qgua2322/ELEC3607_carparkproject/README.md

# ELEC3607_carparkproject
2017 ELEC3607 project9 (USYD):  

## Team members: 
QISHEN GUAN 450549016  qgua2322@uni.sydney.edu.au  
MINGYUAN XIA  450549223

## Manul: 
file fsm : code on arduino   
file schematic: schematic of this project  
file android code: Our own control App  
file testcase : testcase of this project.  
3607report: ALL the detail of this project.  

## How to use:  
1. put fsm in ur Arduino due  
2. put unzip led.zip in file android code and then put it in Android studio then install this app on ur phone.
3. Connect all components as schematic
4. run the testcase to check whether all components are good.
5. Have fun

## Project description :  
The prototype will be in 2 parts, Arduino Due board with a Bluetooth shield in slave mode and an android phone as a controller. There are also several hardware components connected to Arduino in order to complete the full features we expected. 

An android phone acts as a controller (An App will be developed for user); it sends and receives data to/from Arduino board, once the phone connected with the board via Bluetooth(BT), the number of available car parking and further instructions will be displayed on the screen. Once the phone sends command to reserve: available car parking will be updated, and a confirmation message will be received as well. When user wants to leave, send “leave” and billing information will be received. After payment has been confirmed, free to go!

The Arduino Due board takes actions upon commands received via BT. A LCD screen is connected to the board to display number of available car parking, the screen is refreshed at a certain frequency to make sure it updates on time. Once the board receives a command of “reserve”, the board sends a message to corresponding servomotor to open the door. Infrared(IR) senor is detecting whether user’s car has come in or not. After user’s car come in, the board control servomotor to close the door and a time counter starts to work to record the time, which will be used to calculate parking fee. When the board receives “leave” command, billing information can be sent via BT and the payment will be made through a push button (not real payment, for demonstration purpose only). Once payment came through, door opens again and the car is free to go! After the door back to close, available car parking updates again.  

## Flowchart of arduino software:  
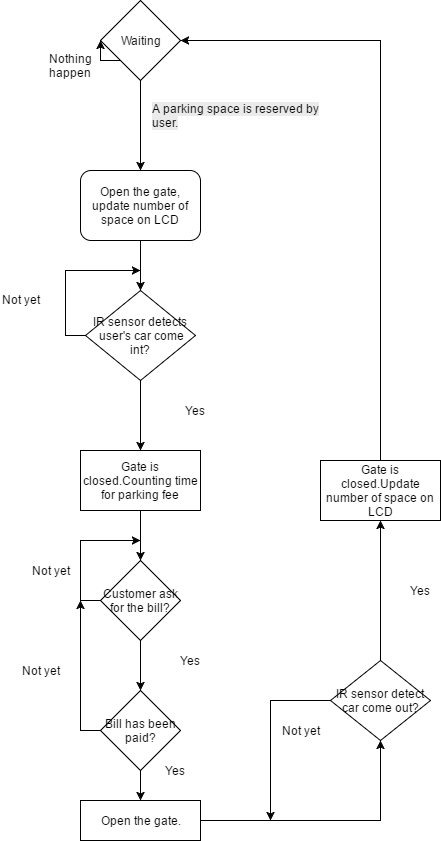
[picture p1: flowchart.png]
flowchart Flowchart


## Schematic: by KiCad
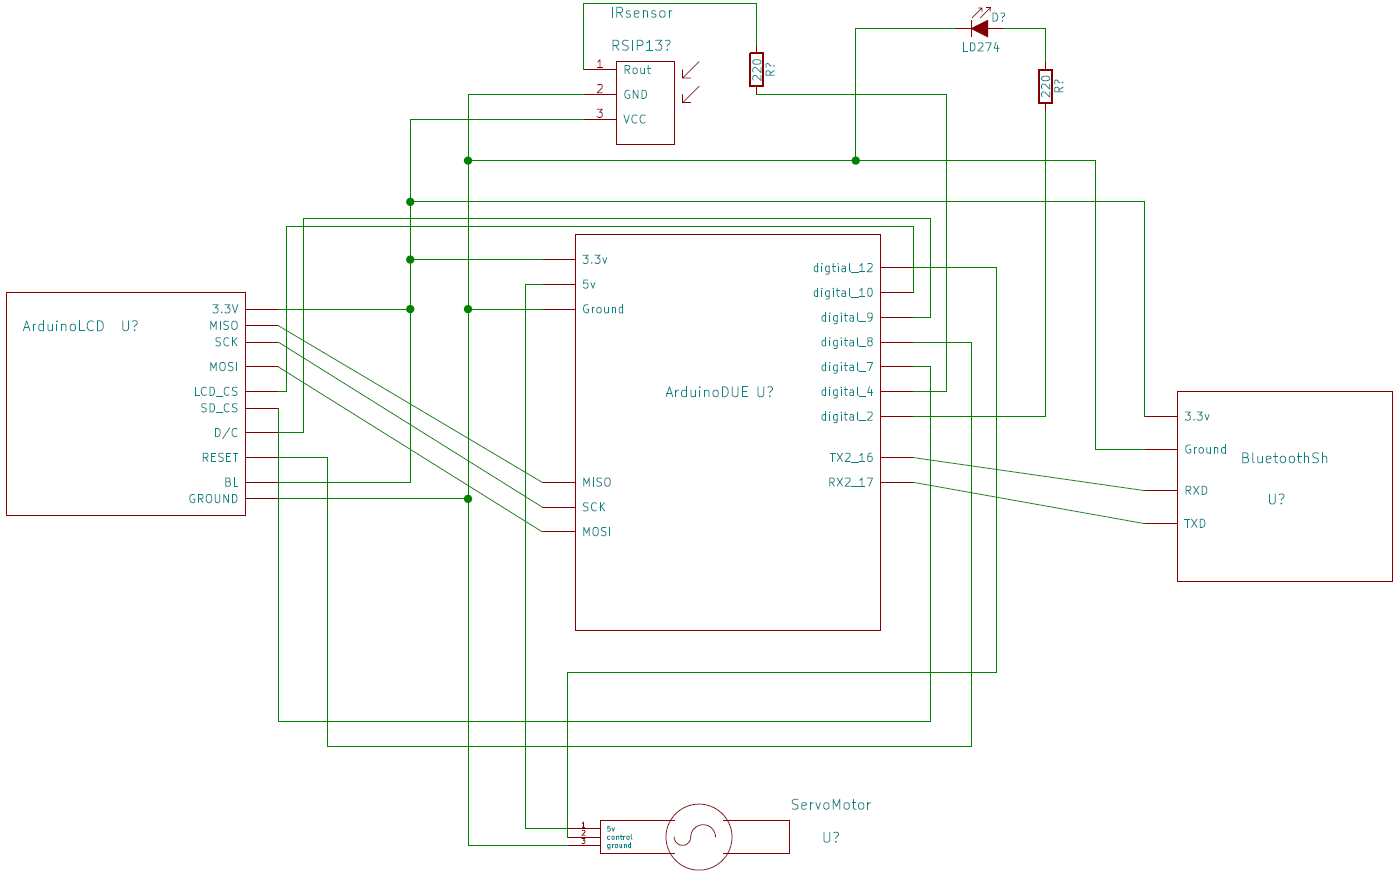
[picture p2: schematic.png]
schematic Schematic


## Reference:
Arduino pin map: https://www.arduino.cc/en/Main/ArduinoBoardDue  
Arduino due schematic:https://www.arduino.cc/en/uploads/Main/arduino-Due-schematic.pdf   
LCD connection:https://www.arduino.cc/en/Guide/TFTtoBoards   
LCD display:https://www.arduino.cc/en/Reference/TFTLibrary  
FSM in Appendeix A:https://flip.ee.usyd.edu.au/seiewiki/Labs/interrupts  
Bluetooth2.0: http://wiki.seeedstudio.com/wiki/Bluetooth_Shield  
Bluetooth4.0: http://linksprite.com/wiki/index.php5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  
Kicad tutorial: https://www.youtube.com/watch?v=o6IWdPpZ4mc  
Android tutorial:https://developer.android.com/training/index.html  
Android control APP: http://www.instructables.com/id/Android-Bluetooth-Control-LED-Part-2/
