qgua2322/ELEC3607_carparkproject/schematic/README.md

If  u just want to see schematic without changing anything, open ELEC3607SC.pdf  

If u want to change something, plz import Mylib.lib, then open ELEC3607SC.sch by KiCad
