qgua2322/ELEC3607_carparkproject/3607report.pdf

# ELEC3607 Project Group 9: A Wireless Car Park Reservation System Final Report Team members: Qishen Guan 450549016 Mingyuan Xia 450549223

# June/2017

# Project Implementation Summary Form

Category | List of items, with web link or page number where item is described
Open source compliance Are you publishing your code as open source? Explain what license you are using, or link to where you have published your project. | Yes, we publish it on github as open source, include all the code and schematic. We use MIT License, then everyone can use our code if they mention us. Link: https://github.com/qgua2322/ELEC3607_carparkproject
Platforms List the platforms you have used, including processor architecture (ARM, AVR, x86, etc.), programming languages (Python, C, C++, etc.), and IDEs. If you are not using Arduino Due, justify your choice of platform. | Arduino due(ARM): C++ Android phone(x86/ARM): Java
Sensors and inputs List your hardware inputs (push buttons, analog sensors, I2C or SPI sensors including accelerometers, etc.) and mention on which page each input is described. | IR sensor(page5)
Outputs List any mechanical, visual or other type of outputs controlled by your hardware (motors, magnets, LED, 7-Segs, LCD, etc.) and mention on which page each input is described. | IR LED, Servo motor, LCD (page 5-7)

Connectivity List any protocols used for communicating between your main controller and any other microcontroller excluding sensors or actuators (USART, UART over USB, Bluetooth 2, Bluetooth 4, Wi-Fi, ZigBee, etc.) and mention on which page each input is described. | Bluetooch 4.0 and Bluetooth2.0(page5-7)
Graphical User Interface List any GUI used for interfacing users (local LCD, Phone app, Desktop app, Web app, Web dashboard, etc.) and mention on which page each input is described. | LCD and custom App on Android (page5-7 for LCD, Page 8 for custom App on Android)
Algorithms / Logic List substantial control algorithms (state-machines, real-time operating system, filesystems, feedback algorithms, mathematical transformations, etc.) and mention on which page each input is described. | FSM (page6-7)
Physical case and other mechanical consideration List what casing or mechanical systems have been used in your project (3d prints, pipes, cardboard mechanics, etc.) and mention on which page each input is described. | NO

### 1. Abstract

The following project we designed and built is a wireless car parking/billing system. An android device is allowed to communicate with the prototype via Bluetooth 4.0 by using our customized android app. At the car parking lot, a LCD screen will display the number of available car parking, this information is sent to paired android phone as well. On the other hand, the phone app plays the role of a remote controller, it has “reserve”, “leave”, “pay”, “disconnect” buttons and fulfill these functions correspondingly. This will be discussed in detail in Design section. After we built the prototype, we ran tests to test whether it achieved our goal. We found that it was hard to synchronize Arduino Due and the phone, so we always lose a word or two upon receiving messages. This will be expanded in Trouble-shooting section. After the tests, although we approached our expectations, there is much more thing can be done to improve, such as using WIFI instead of BT; but due to time limitation, we left our prototype as what it was. This project is extremely helpful in regarding to gain a better understanding of communications between embedded system & others, and simple real world embedded system design.

### 2. Aim and difficult:

Live in city like Sydney, a daily headache is to find a parking spot at your travel destination. The time of finding a spot occupies a great percentage of your commuting time, if you live in city, the percentage is even higher. Therefore we came up with an idea of a wireless parking/billing system that can check availability and reserve a parking spot before your arrival. Furthermore, you can also view your bill on the phone in real time and pay your bill when you are leaving.

3.Design:
3.1: Components list:
Equipment : | amount
Arduino due | 1
Bluetooth 2.0 shield | 1
Bluetooth 4.0 shield | 1
Servo motor | 1
IR LED | 1
IR sensor | 1
LCD display | 1
Resistor 220 (ohm) | 2

3.2: Use of each components:
Arduino Due board is the core of this embedded system. All the other components are connected on it. It process the message that is sent from user’s App, then output the response to LCD and user’s App at the same time. And control the parking space’s gate open or off by reading IR signal.

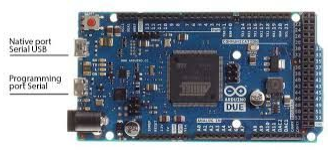
[picture p5: figure]

Bluetooth 2.0/4.0 shield provide a wireless connection between embedded system and user’s phone App. (Our project used BT2.0 at first, then switch to 4.0 later, Check 3.7 How does this project work to see how to use different version of BT)

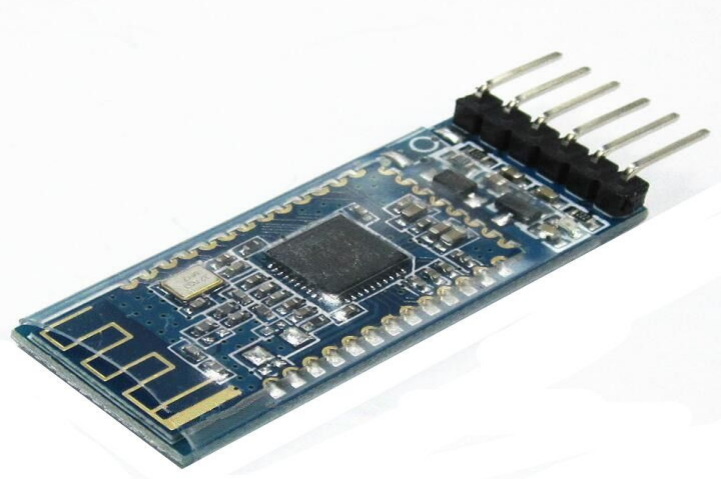
[picture p6: figure]

Servo motor is used to open/close the gate of our parking space

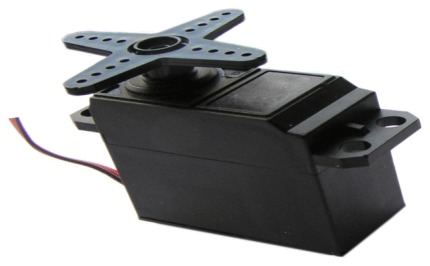
[picture p7: figure]

IR LED and IR sensor is used to detect whether customer’s car has parked in or not, in order to close the gate automatically when car has parked in or close the door when customer has left. The reason that choose infrared as detection light is: infrared light is not common in environment light, so it will not be impact very easy by environment. And it is invisible for human.

LCD screen always display the number of free space is remaining, and display the information at each stage. For example: display how long does user’s car have been parked in/ How much does user have to pay.

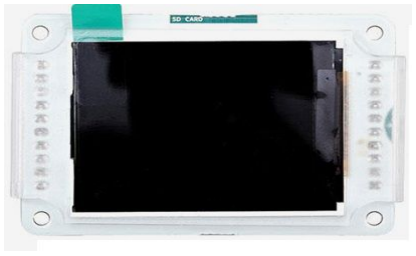
[picture p8: figure]

### 3.3 Hardware schematic: Appendix 1

### 3.4 Software flowchart: Appendix 2

### 3.5 Arduino code: Appendix 3

### 3.6 Android App’s code: Appendix 4

### 3.7 How does this project work:

This system uses a Finite state machine(FSM) as the control mechanism, because in FSM we don't need to worry about customer mispress some wrong button(Except "Disconnect"),then the system get into an unknown situation. For example, nothing will happen when customer press "pay" before "leave".Things only be processed in a sequence that we want.

Bluetooth is used as wireless connection, but Arduino Due board does not support SoftwareSerial library, so we need to implement hardware serial to Bluetooth, in order to get it work. (Bluetooth’s TX connect with Arduino’s Serial2’s RX, bluetooth’s RX connect with Arduino’s Serial2’s TX, this is same for both BT2.0 and 4.0. If choose Bluetooth 4.0, uncommand setupBlueToothConnection4() in function void setup() in fsm.ino , command setupBlueToothConnection(), and vice versa.
)

This embedded system implement two Timer counters(TC) to achieve time counting and generate a squarewave. We turn TC0 on to generate a 36K Hz square wave signal on digital pin 2, because Arduino Due does not support Tone library. We generate such high frequency signal because it isn't common in environment light, so it is not easy to be affected by surrounding circumstance. TC1 is used to count how long does user’s car stay.

Expected operating procedure: When user press “reverse” button on the phone, our embedded system will control the servo motor to open the gate, and update number of free space on LCD. The system will not count time immediately, it will wait until IR sensor detect user’s car has parked in, and the gate is fully closed. After that embedded system will update the time to LCD and user’s phone simultaneously. When user decide to leave, all he needs to do is to press “leave”, then the bill will come up on LCD as well as user’s phone. Once user press

“pay”, the user is good to go. System will control motor to open the gate, and it will only close after IR sensor detects IR light(meaning the car has left).

3.8 Design verification and result.

IR LED and Sensor: IR light is invisible to human eye, so we used an android phone’s camera with a IR filter to check whether it is operating, And we see a purple light show on IR LED when it is operating. To test IR sensor, we put IR LED face with IR sensor, when there is nothing a ‘0’ show on monitor. After that we put a book in between, a ‘1’ show on monitor, when we remove it ‘0’ come back.

Servo motor: myservo.write(30); move forward, myservo.write(120); move backward myservo.write(90) stop. Work as expected. LCD: We print a “hello world” on LCD by TFTscreen.text("Freespace:.", 0, 40); then change the second or third argument of this function to change the position on the LCD screen. Change first argument to output different string. It all work as we expected.

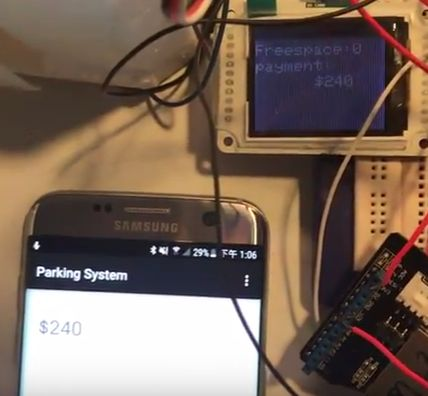
[picture p9: figure]

Bluetooth 4.0 and App: Using off the shelf App: Bluetooth Terminal to send and receive some Strings from embedded system. No characters lost in sending or receiving String. Using our customised app, no charate lost in Sending message to embedded system, some character lost in receiving String from embedded system. We decide to add space buffer to the String being sent from embedded system. No chartered lost anymore.

FSM: we test our FSM by pressing the button on the App in unexpected sequence. Like press “pay” before “leave”. No matter what we did, the system only operated in a sequence that we expected. (Unless someone reset the board,or disconnect the power, then that App may break or receive a error message.)
All parts are being verified as what we expected.

App design:
The android app is designed base on an android Bluetooth app tutorial using android developer tool called Android studio, this tutorial is in the reference named Android control app.(Ref 10) The tutorial provides a detailed procedure of creating an app that uses Bluetooth as communication tool. We used the tutorial as a learning material, and create our app follow the tutorial structure. Then we modified our code based on it to suit our needs.

We added more buttons to the user interface and complete their functions correspondingly. We add a textview widget to continuously refresh information displayed on the phone, this is done by using MyAsyncTask(). What it does is to create another thread that will constantly read input string from Bluetooth socket in background. A Timer() is introduced to delay the initialization of MyAsyncTask in order to keep the welcome screen for few seconds. The Timer also controls the time between every execution of MyAsyncTask;therefore the information displayed is refreshed at certain frequency without being interrupted by other button operations. The app happened to crash several times during testing, we managed to sort this out somehow, but as this project is not focused on android we didn’t go deep into it and stopped at where we thought it was enough.

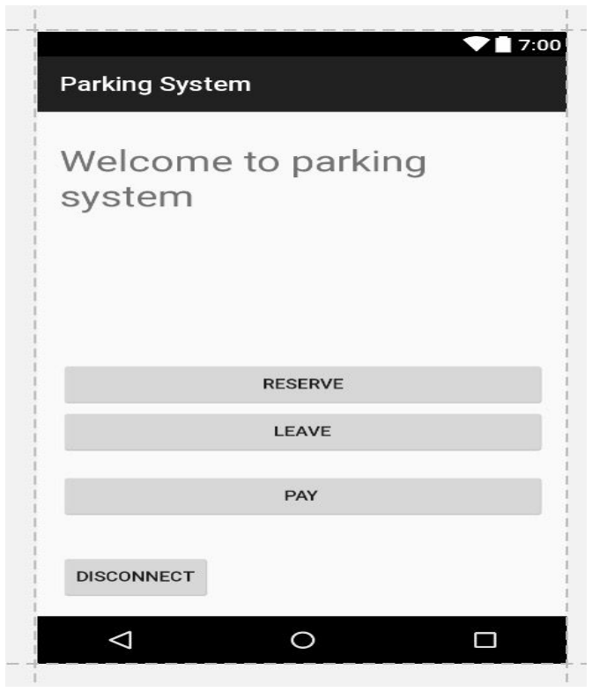
[picture p10: figure]

4.Trouble-shooting:
There were both hardware and software problems occurred during this project:
1. In order to communicate with phone via Bluetooth, we add a Bluetooth shield to Arduino Due board. Normally, when adding a Bluetooth shield to Arduino, we plug the whole shield on top of Arduino board to let pins on the Bluetooth shield inherits the pins on Arduino. But for this particular Arduino Due board, if we had done the connection this way, many digital pins on the Due board will be blocked by the shield; and we do need those pins to fulfill our other functions, for instance the pins to connect LCD’s
MISO,MOSI and SCK were blocked by the shield. Therefore we decided to power up the shield via wires and connect output/input pins as well. Although this connection takes more space, it provides a large range of accessible pins to suit our needs.
2. A proper installation of LCD screen onto breadboard could not be done due to the width of LCD screen. The LCD screen happened to be a bit wider than the width of pin matrix on breadboard; therefore we could not plug in both pin vectors on breadboard. Fortunately, after researching, we found that only connect the pin vector on left is enough to drive the LCD screen. So we plugged in the left half and let the right half hang at edge of the breadboard.
3. In regarding to the detection of whether the car is in parking lot, we used a pair of IR LED and IR sensor. Upon testing if this pair is working, we found that our sensor could not detect the IR light from IR LED. This meant either our LED was not working or our sensor was broken. To test the IR LED, we used a phone camera that turns IR filter off and we saw nothing is emitting from the LED.So we went back to double check our code which drives LED and as well as our circuit connection. We used oscilloscope to measure voltage across LED, the result showed it was in right frequency but Vpp was too low. Due to this, we reduced the resistance of series resistor (voltage divider) to 230 ohms to allow more voltage drop across the LED. After this we used camera again and observed a purple-ish light was emitted from LED but only at a certain angle. We corrected the LED position to ensure the IR light will propagate to IR sensor and successfully detected the IR light.
4. The synchronization issue was the main software problem encountered in this project. In our design, the Arduino Due will send messages to the phone via Bluetooth, and the app will pick up the messages then display on the phone screen. But as they were not synchronized, every time the massage was refreshed on screen, it might lose some part of the original message. For example, Arduino sends “freespace: 1” but only an “eespace: 1” message will appear on the phone. In order to solve this, rather than dig deep to understand both devices’ operating rates, we decided to solve this in a much simpler and less time consuming way: adding buffer. Instead of sending “freespace: 1”, we modified our code to send with buffer “ freespace: 1 ”. On the other hand, the code of app was modified to display everything that is not a “space”. For instance, if the Arduino sent “ freespace: 1 ” and the phone received “ freespace: 1 ”, the buffer at front did it work and maintain the main message. After automatically deleting spaces, a message of “freespace: 1” will be displayed on screen. Although this solution is not perfect, it satisfies our need at this stage.

### 5. Improvements

Our project has a great potential in terms of improvements：
The first that comes to our mind is to use WIFI instead of Bluetooth for communication; this will improves the communication range by a large factor to make this project more practical and utilized.

Secondly, as mentioned in trouble-shooting, dig into the synchronization issue and solve it from a deeper level. This will make our app react faster and improve the stability under load.

Additional improvement for app would be a better looking user interface which is user friendly. In terms of the prototype, we could add more components to achieve more functionality. For example, we could add red and green LED to indicate if there is any available parking spot; use LCD to display more information and even images; create more parking spots; add temperature sensor to detect fire emergency and a speaker to warn people if emergency occurs.

6.Cost:

Component: | Price | quantity | Total
Arduino due | 50 | 1 | 50
Bluetooth 2.0 shield | 20 | 1 | 20
Bluetooth 4.0 shield | 59 | 1 | 59
Servo motor | 16 | 1 | 16
IR LED | 1 | 1 | 1
IR sensor | 2.5 | 1 | 2.5
LCD display | 22 | 1 | 22
Resistor 220 (ohm) | 0.1 | 2 | 0.2
Total | | | 170.7(AUD)

### 7. Conclusion

In conclusion, we successfully implement a wireless car parking/billing system using Arduino Due and an android phone. Our prototype completes most of our expectations and at some point it even exceeds our plan. (“Pay button” in app replaces the hardware button in the original plan) We worked hard and put efforts into this project as it continuously give us positive feedbacks and joy. This experience is valuable to us because it is like a bridge links the theorem to reality. By designing and completing this project, we have gain experience on how to apply our knowledge to a real world problem/application. Although this project is rather simple than anything that is worthy to talk about, it is a great start for understanding embedded systems. Additionally, this project reinforced our team-work skills such as communication skills as it requires a team work.

Open Source to GITHUB：https://github.com/qgua2322/ELEC3607_carparkproject

Reference :
1.Arduino pin map: https://www.arduino.cc/en/Main/ArduinoBoardDue
2.Arduino due schematic:https://www.arduino.cc/en/uploads/Main/arduino-Due-schematic.pdf 3.LCD connection:https://www.arduino.cc/en/Guide/TFTtoBoards
4.LCD display:https://www.arduino.cc/en/Reference/TFTLibrary
5.FSM : https://flip.ee.usyd.edu.au/seiewiki/Labs/interrupts
6.Bluetooth2.0: http://wiki.seeedstudio.com/wiki/Bluetooth_Shield
7.Bluetooth4.0:
http://linksprite.com/wiki/index.php5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 (http://linksprite.com/wiki/index.php5)
8.Kicad tutorial: https://www.youtube.com/watch?v=o6IWdPpZ4mc
9.Android tutorial:https://developer.android.com/training/index.html
10.Android control APP: http://www.instructables.com/id/Android-Bluetooth-Control-LED-Part-2/

Appendix 1 : Schematic by Kicad (Please go to github for a better version)

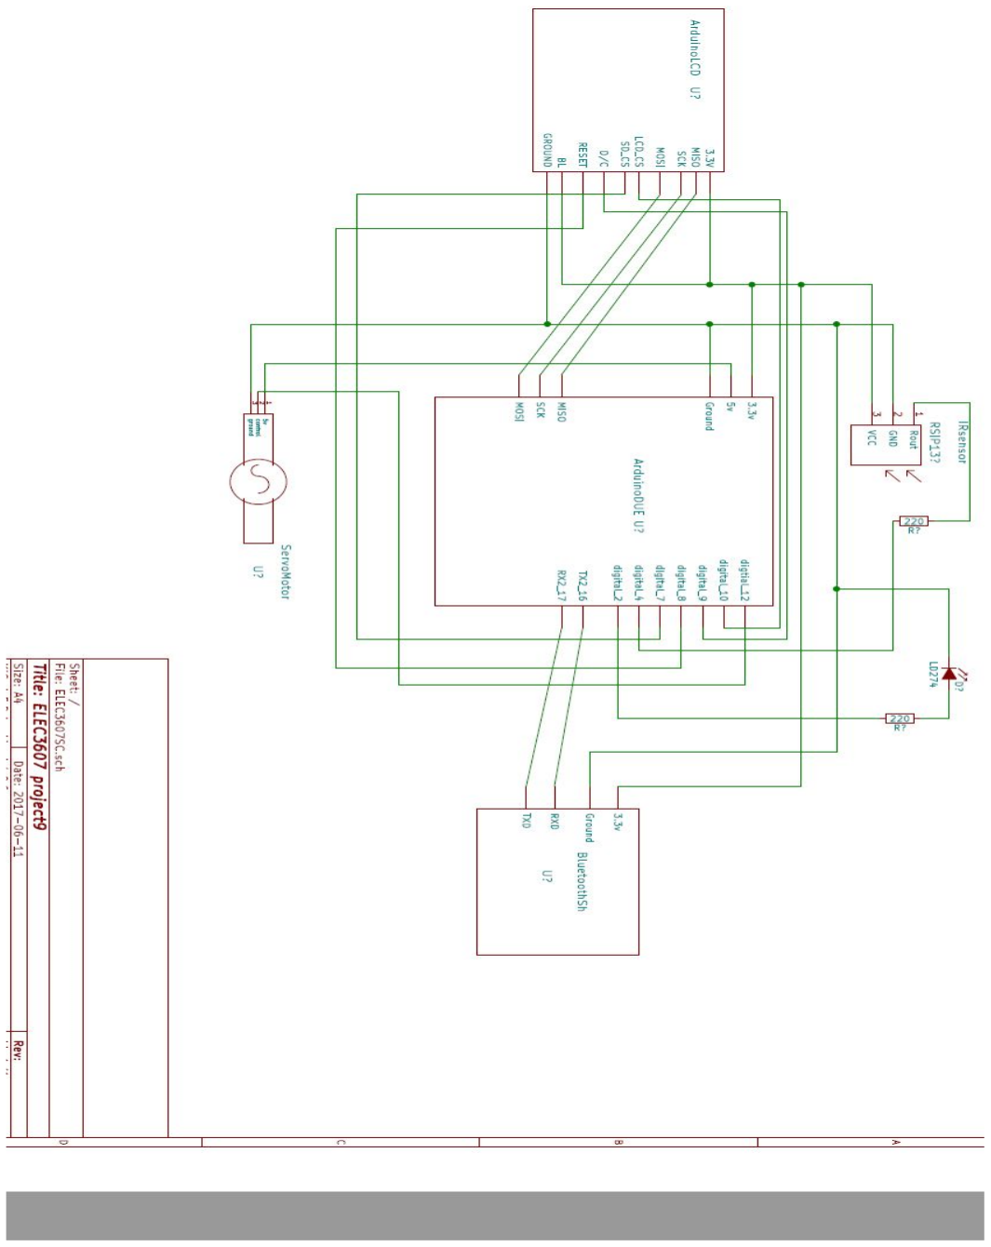
[picture p11: figure]

Appendix 2: software flow chart

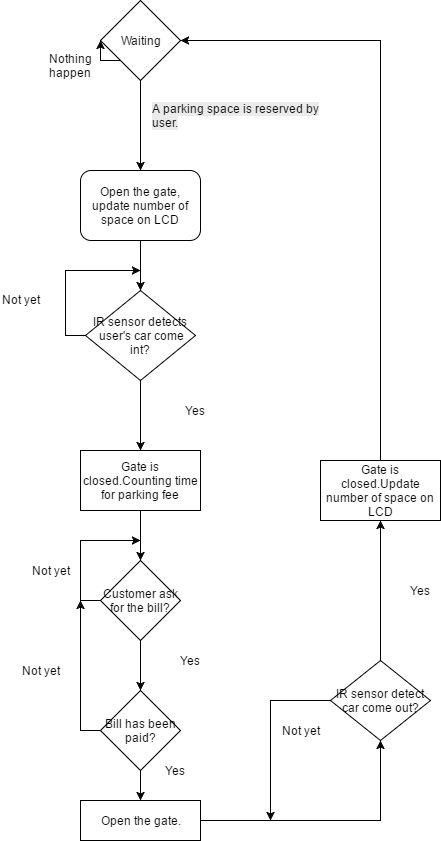
[picture p12: figure]
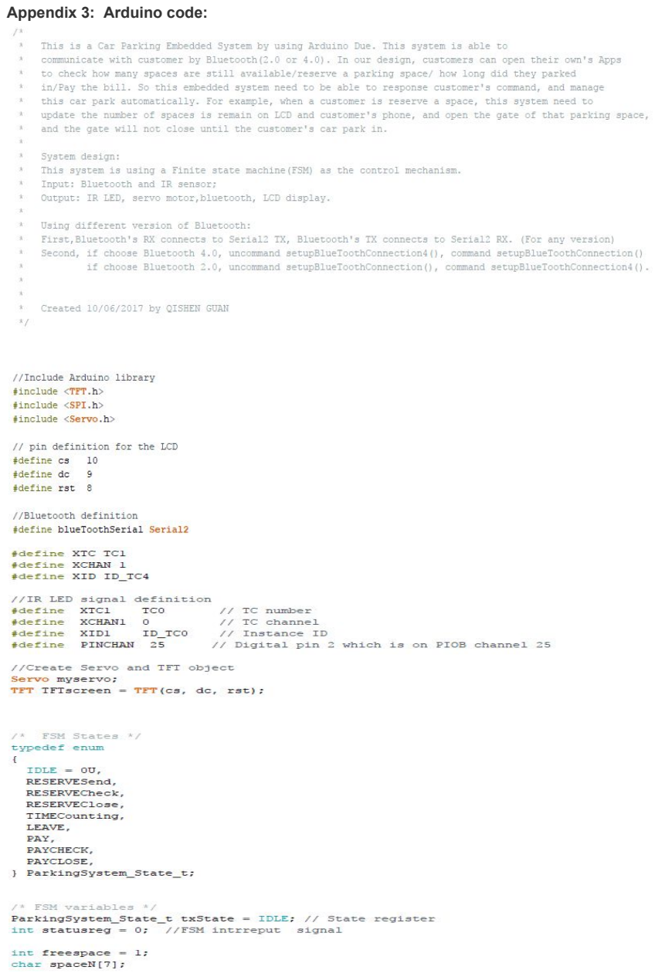
[picture p13: page 14]

Appendix 3: Arduino code:

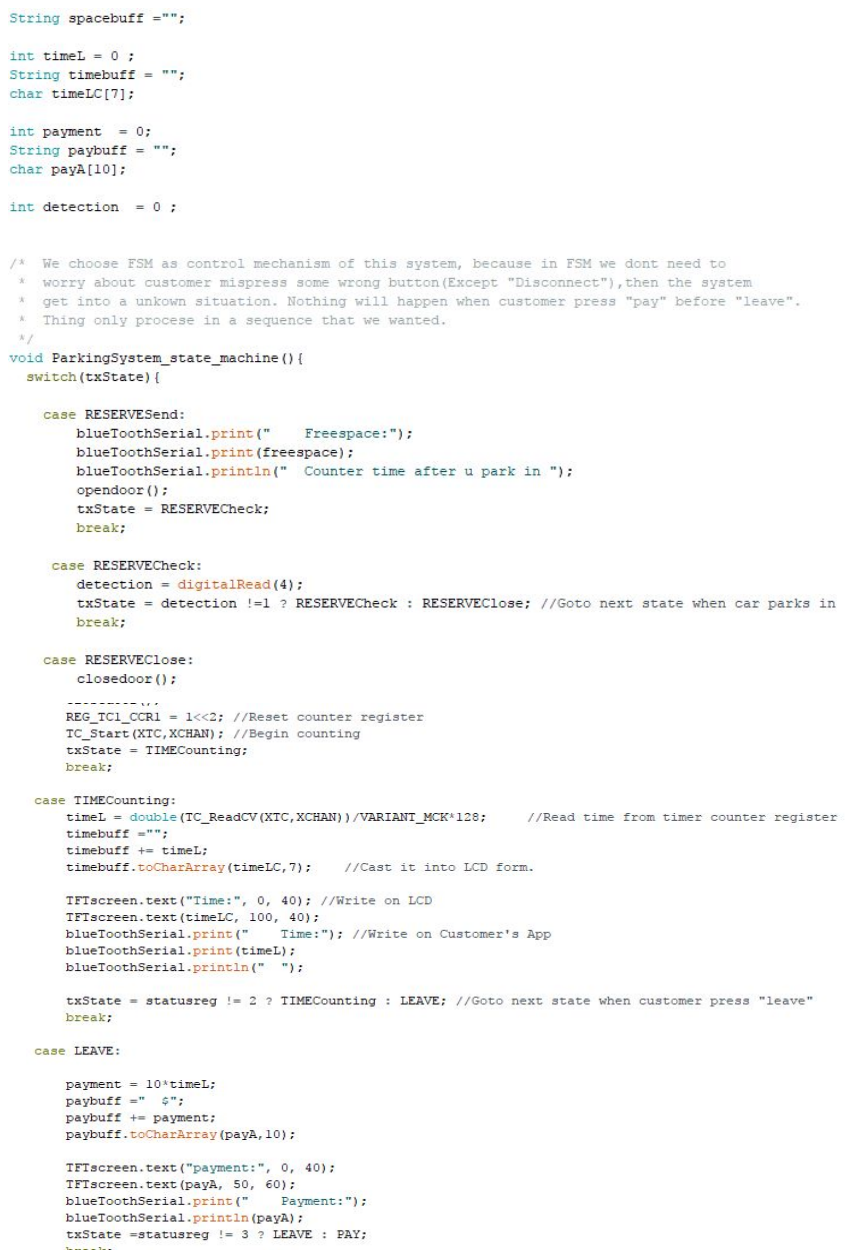
[picture p14: page 15]

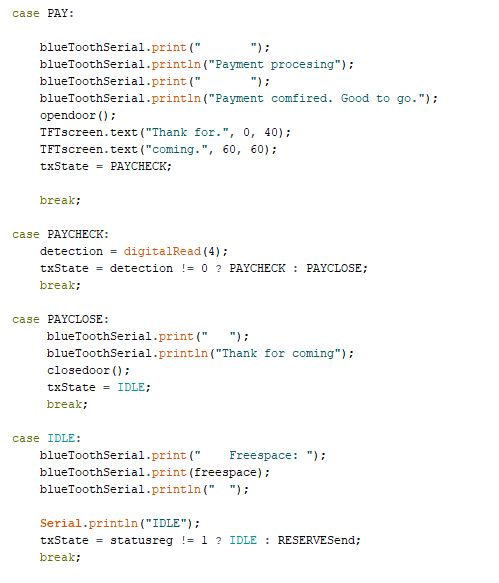
[picture p15: figure]

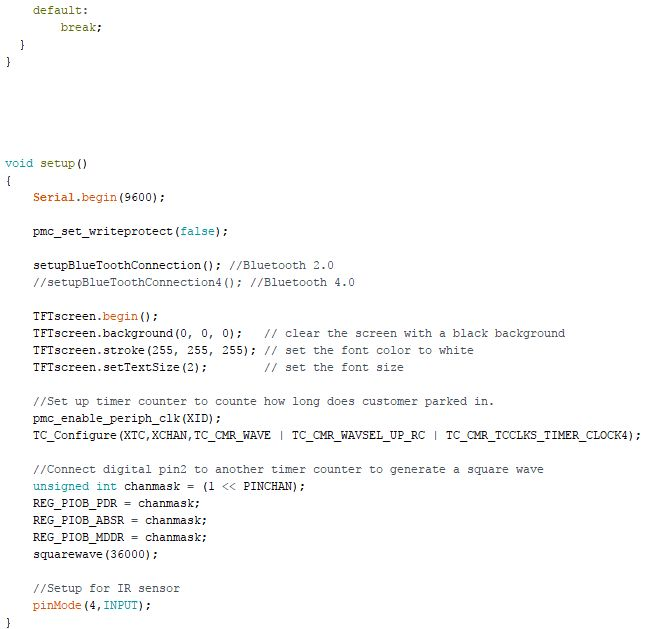
[picture p16: figure]

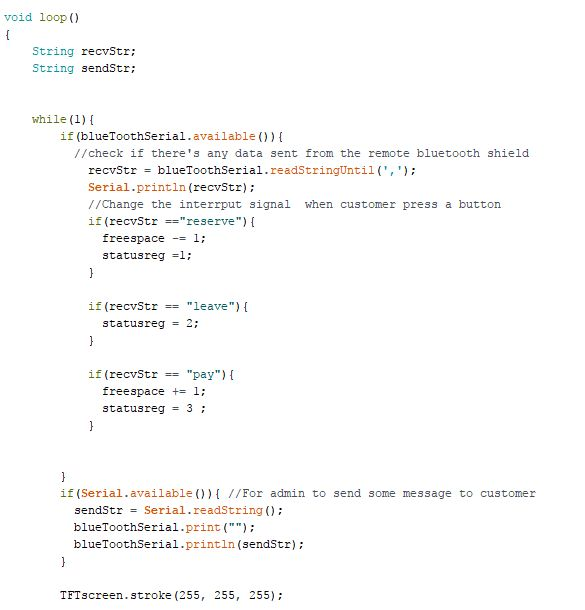
[picture p17: figure]
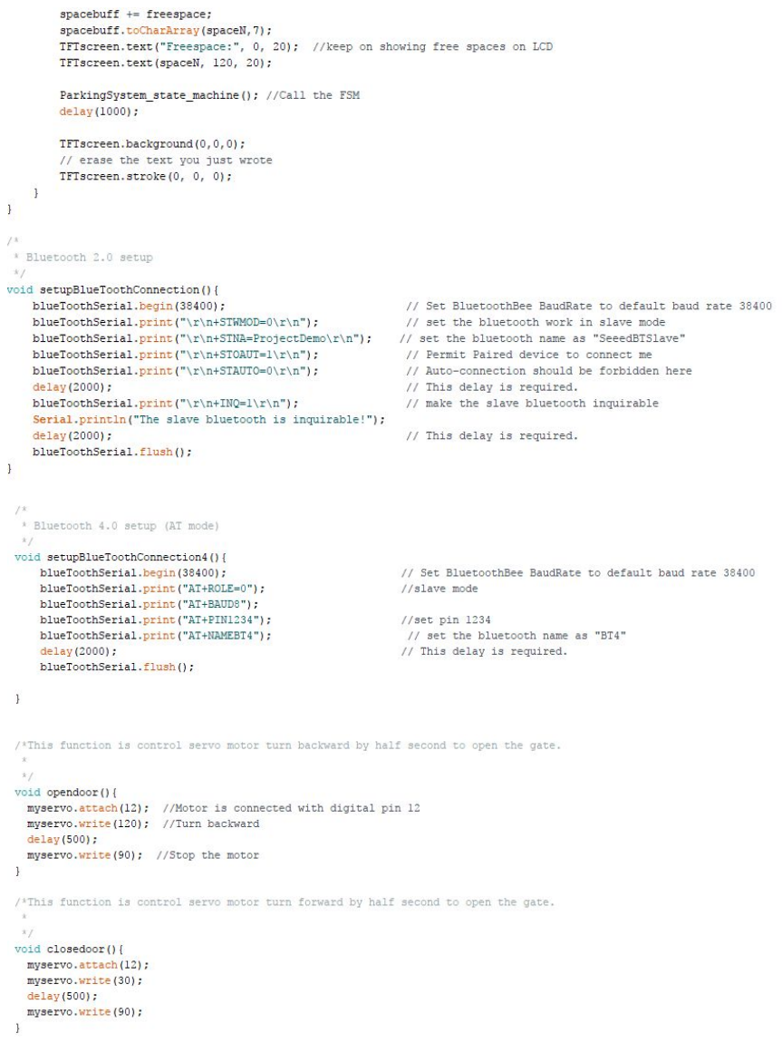
[picture p18: page 19]

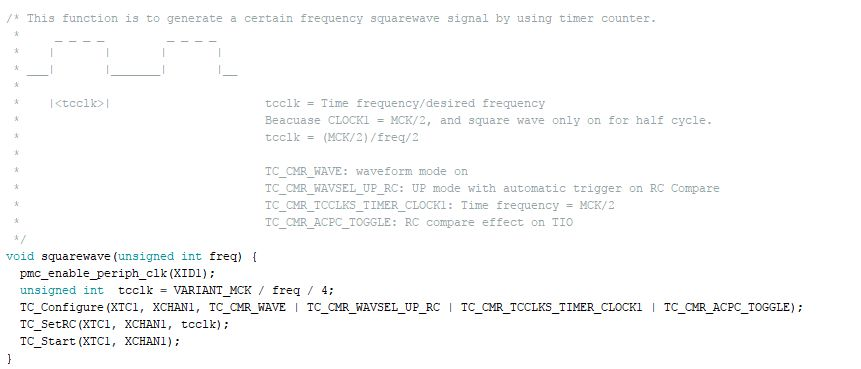
[picture p19: figure]

Appendix 4: Android code: Control.java

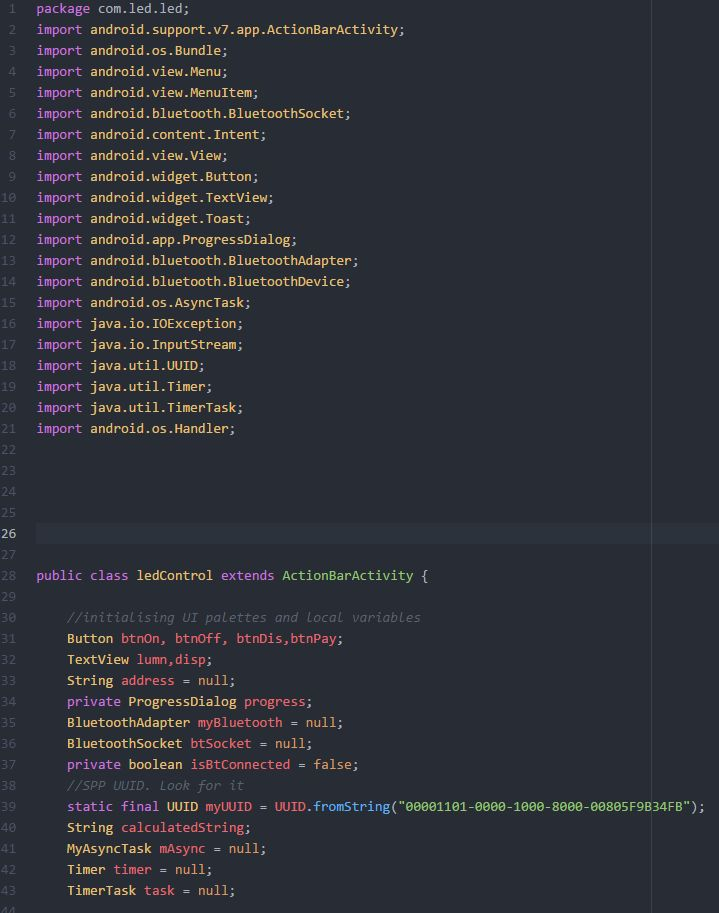
[picture p20: figure]

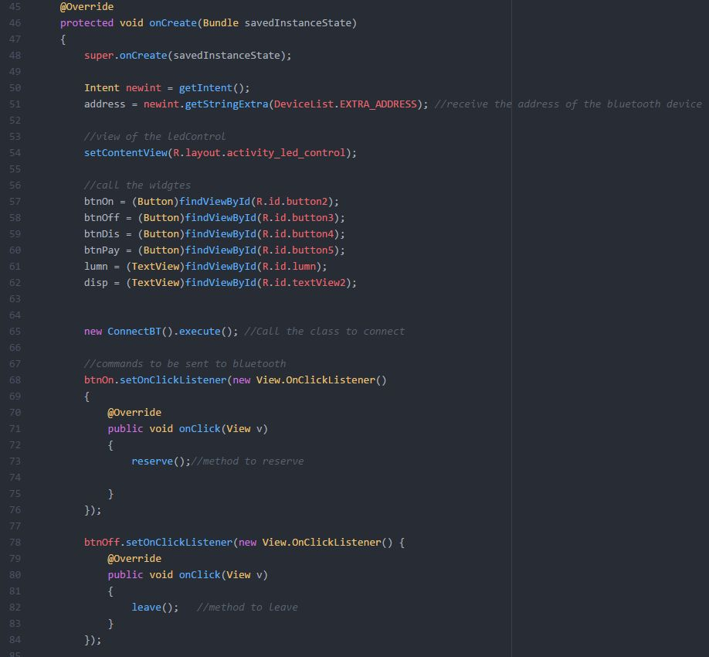
[picture p21: figure]

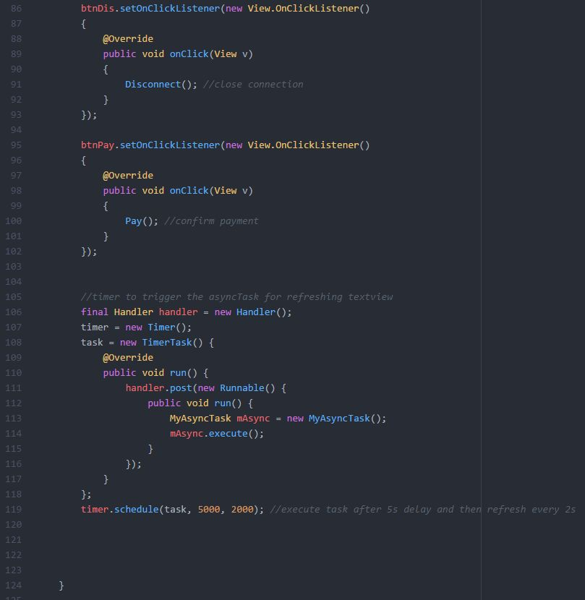
[picture p22: figure]

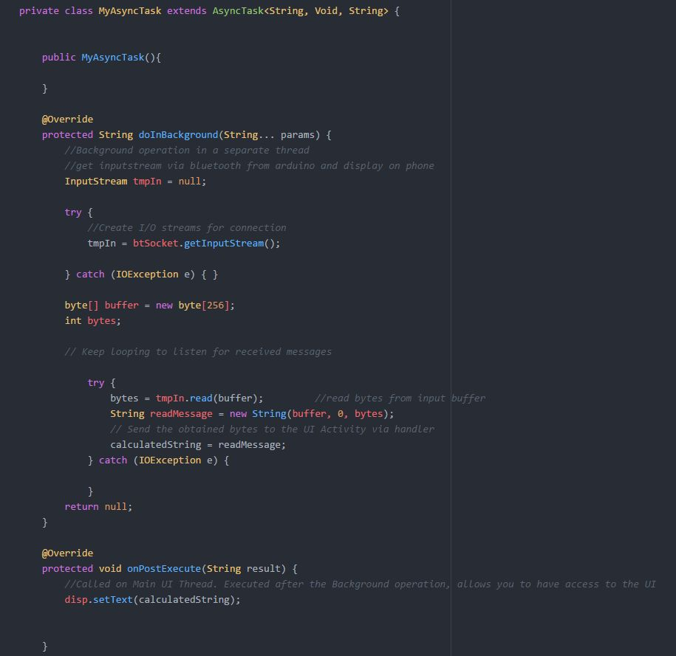
[picture p23: figure]

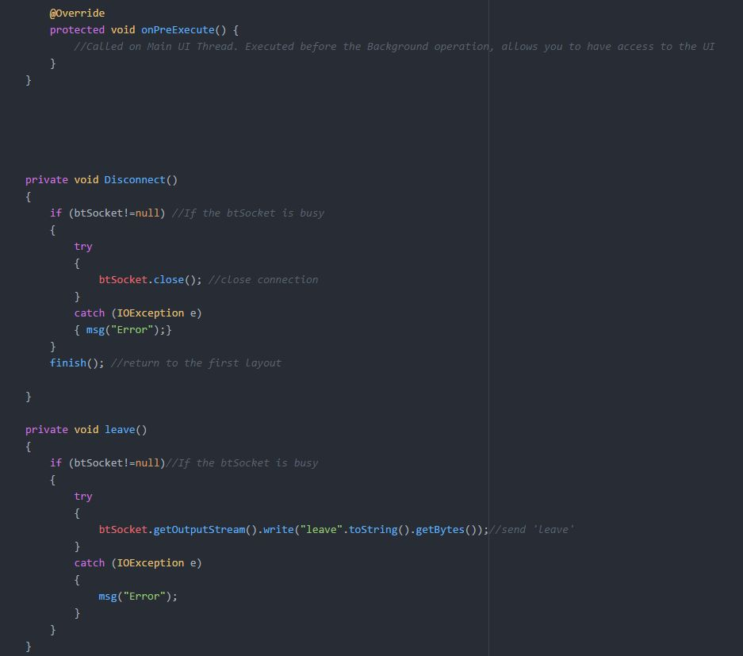
[picture p24: figure]
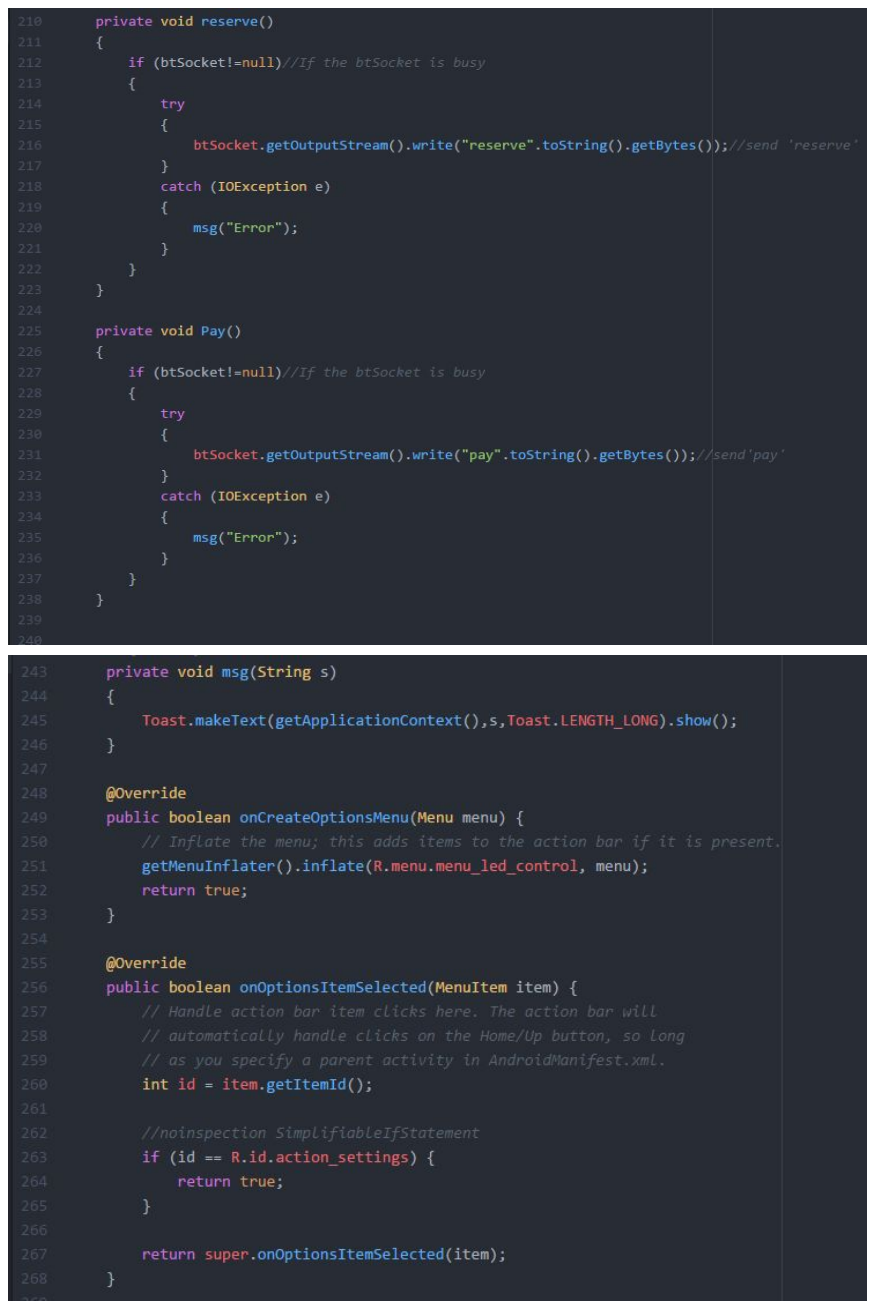
[picture p25: page 26]
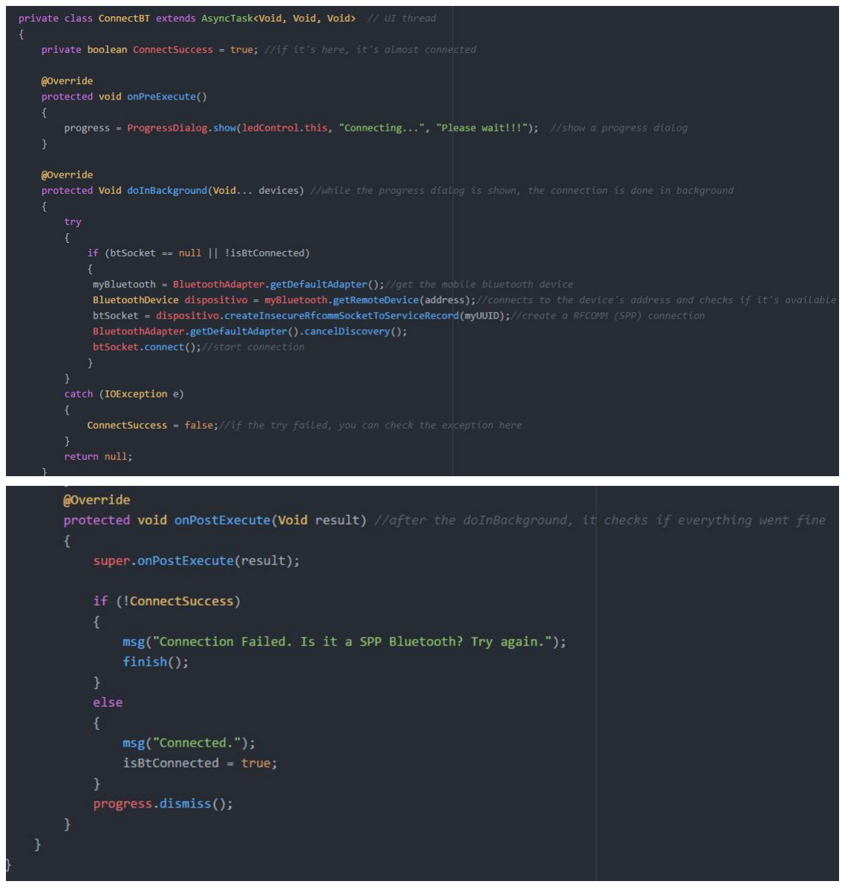
[picture p26: page 27]

Android code: DeviceList.java

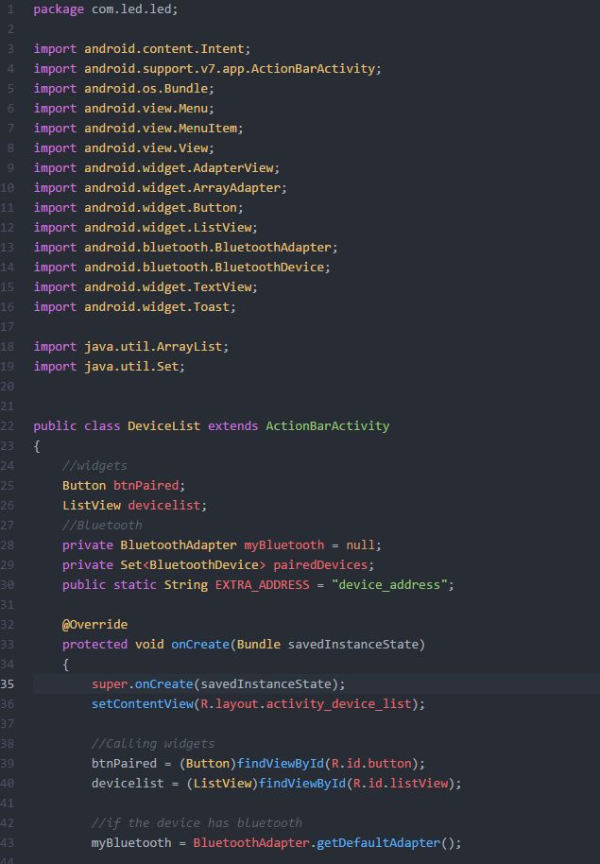
[picture p27: figure]
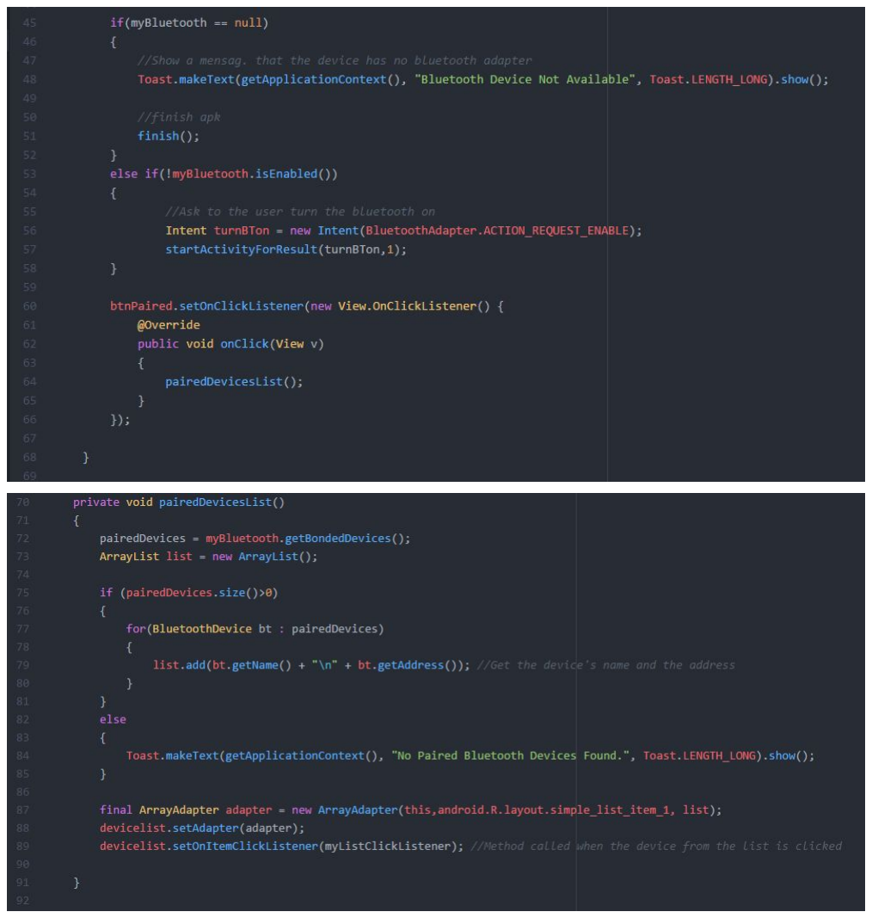
[picture p28: page 29]

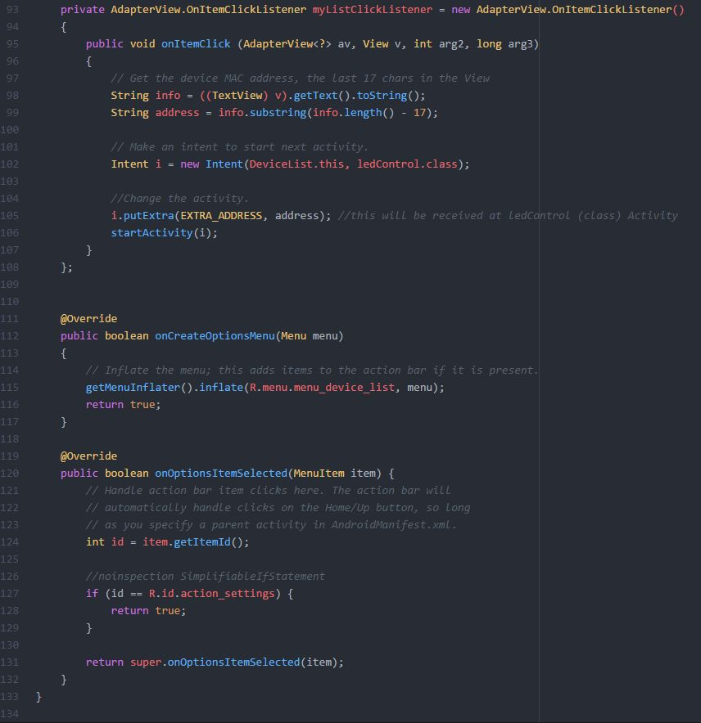
[picture p29: figure]
