qgua2322/ELEC3607_carparkproject/testcase/testcase.txt

Test cases:
1.	Pair device ¨C reserve ¨C door opens ¨C park in ¨C door closes ¨C wait few seconds ¨C leave ¨C pay ¨C door opens ¨C car left ¨C door closes ¨C back to first state.
2.	Pair device ¨C reserve ¨C door opens ¨C park in ¨C door closes ¨C wait few seconds ¨C leave ¨C  do not pay ¨C door keeps closed until pay ¨C door opens - car left ¨C door closes ¨C back to first state.
3.	Pair device ¨C reserve ¨C door opens ¨C do not park in ¨C door keeps open ¨C park in - door closes ¨C wait few seconds ¨C leave ¨C pay ¨C door opens ¨C car left ¨C door closes ¨C back to first state.
4.	Pair device ¨C reserve ¨C door opens ¨C park in ¨C door closes ¨C wait few seconds ¨C pay ¨C nothing happens - leave ¨C pay ¨C door opens ¨C car left ¨C door closes ¨C back to first state.
5.	Pair device ¨C leave ¨C nothing happens ¨C pay ¨C nothing happens ¨C disconnect ¨C app quits
