qgua2322/ELEC3607_carparkproject/testcase/ReadMe.md

testcase.txt is the testcase for this whole project.  

If u want to test individ component, plz open functiontest.
