qgua2322/ELEC3607_carparkproject/schematic/ELEC3607SC.pdf

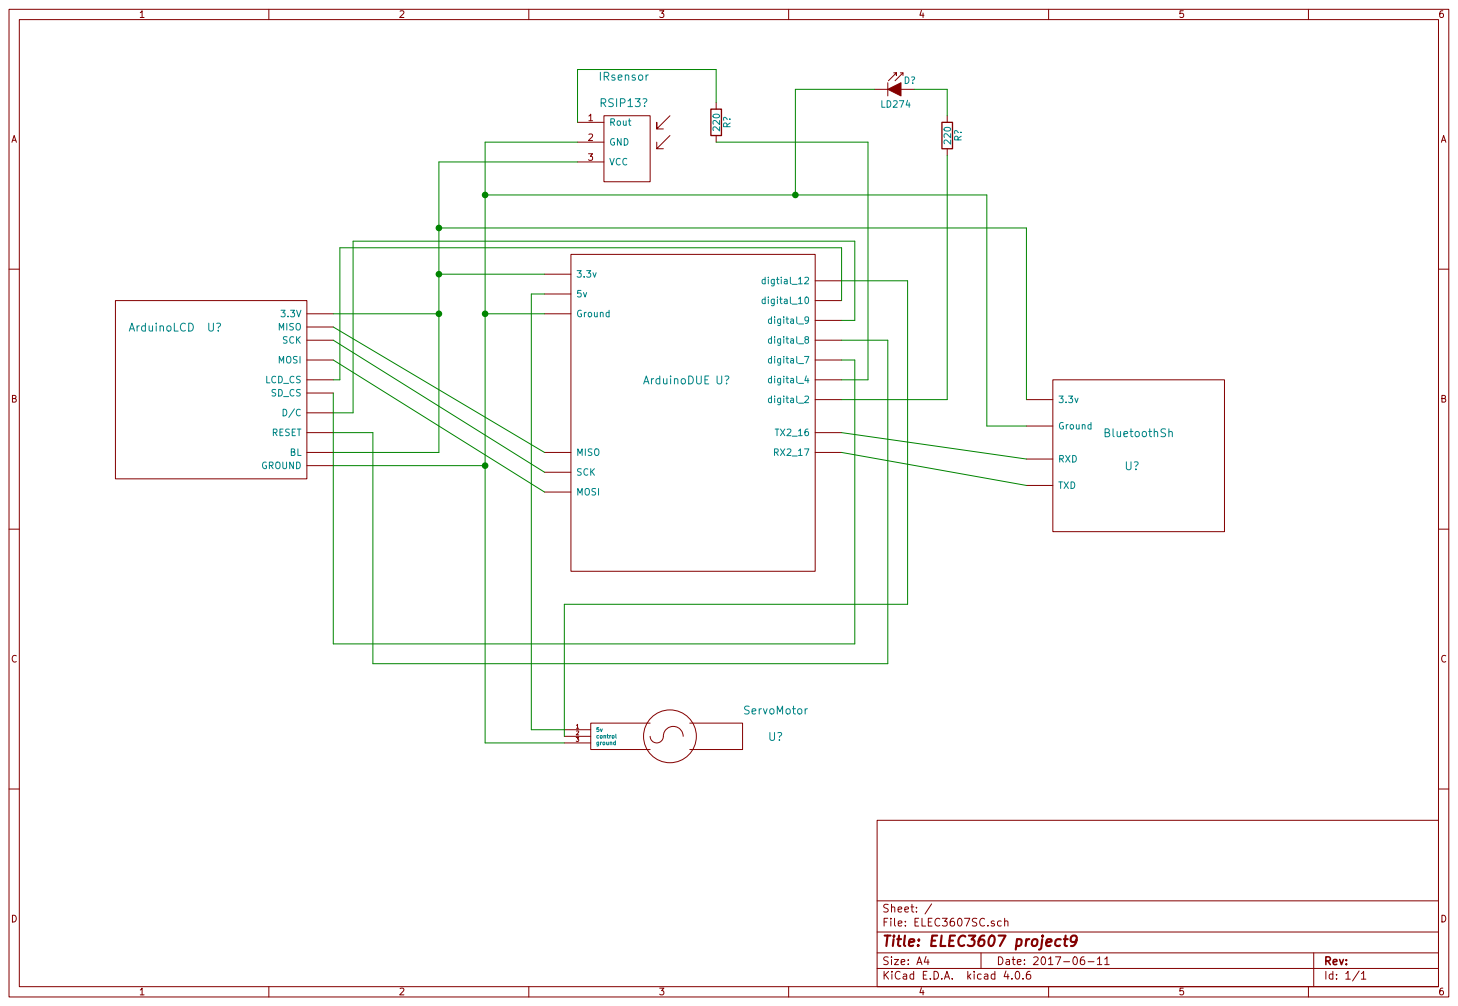
[picture p30: page 1]

LCD_CS MISO MOSI RESET SCK
